hpvdt/falcon_motherboard/README.md

# Motherboard

Firmware and hardware designs for the Falcon motherboard.
