hpvdt/falcon_motherboard/hardware/motherboard_rev_3/motherboard_rev_3.kicad_pcb

## KiCad design hardware/motherboard_rev_3/motherboard_rev_3.kicad_pcb (2025-08-23)

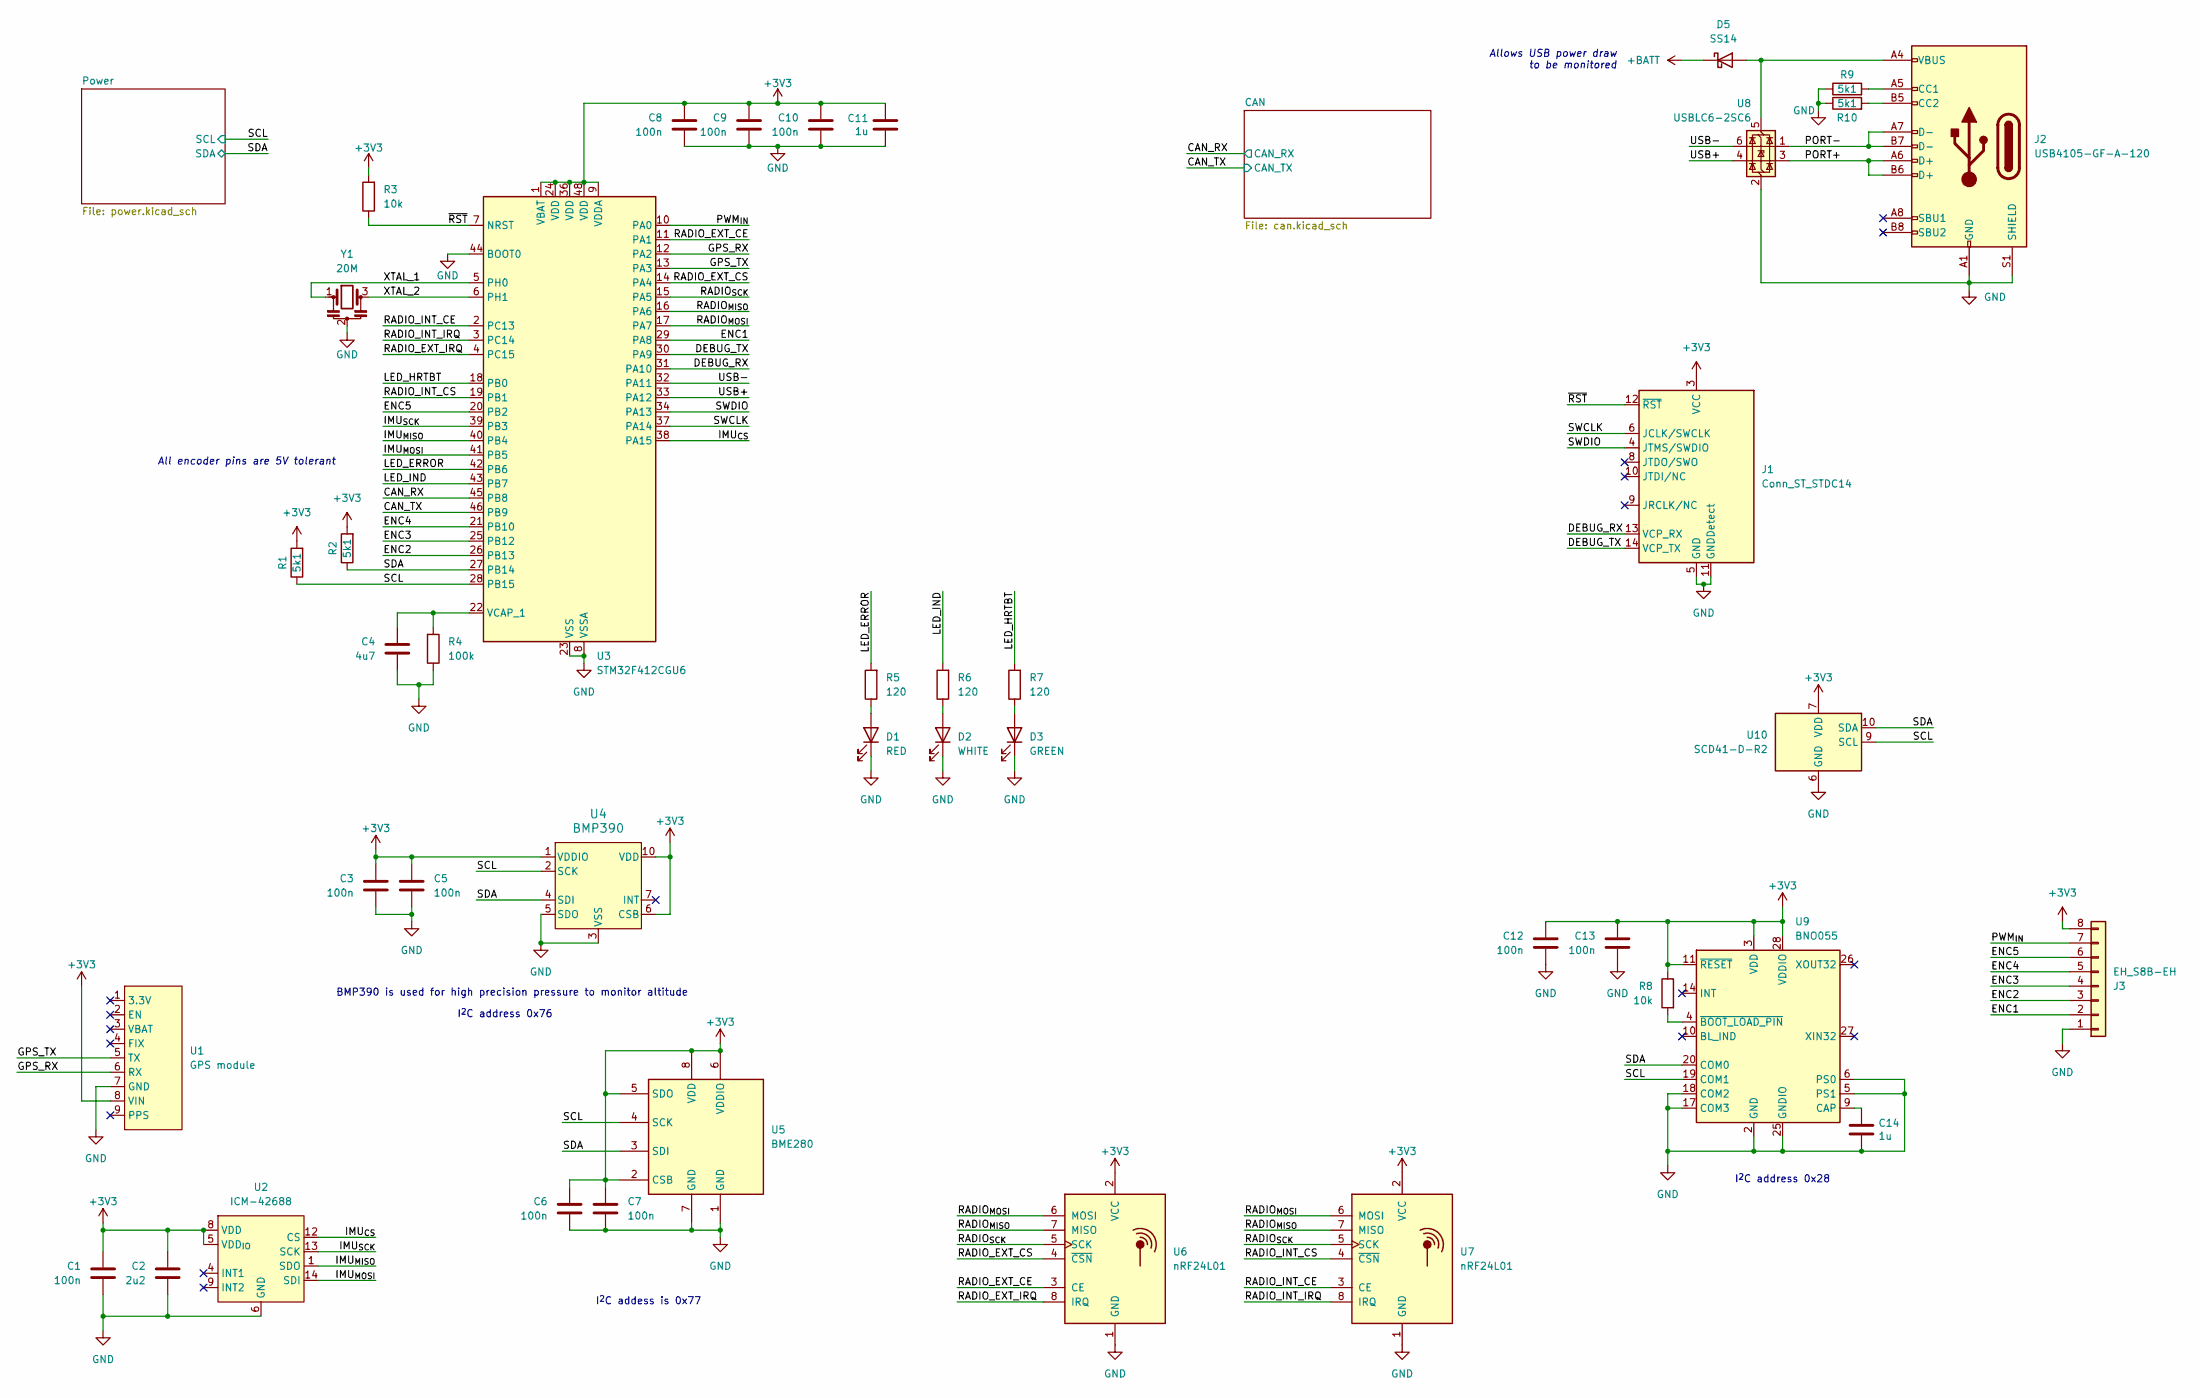
[picture p1: schematic motherboard_rev_3.kicad_sch, Falcon Motherboard]

Parts:
C1, C3, C5, C6, C7, C8, C9, C10, C12, C13: 100n; C_0402_1005Metric; LCSC C301928
C2: 2u2; C_0402_1005Metric; LCSC C12530
C4: 4u7; C_0603_1608Metric; LCSC C1705
C11, C14: 1u; C_0402_1005Metric; LCSC C52923
D1: RED; LED_0805_2012Metric; LCSC C84256
D2: WHITE; LED_0805_2012Metric; LCSC C34499
D3: GREEN; LED_0805_2012Metric; LCSC C2293
D5: SS14; D_SOD-123F; LCSC C2909920
J1: Conn_ST_STDC14; PinHeader_2x07_P1.27mm_Vertical_SMD; LCSC C2881912
J2: USB4105-GF-A-120; USB_C_Receptacle_GCT_USB4105-xx-A_16P_TopMnt_Horizontal; LCSC C5184243
J3: EH_S8B-EH; JST_EH_S8B-EH_1x08_P2.50mm_Horizontal; LCSC C265106
R1, R2, R9, R10: 5k1; R_0402_1005Metric; LCSC C25905
R3, R8: 10k; R_0402_1005Metric; LCSC C723353
R4: 100k; R_0402_1005Metric; LCSC C25530
R5, R6, R7: 120; R_0402_1005Metric; LCSC C25079
U1: GPS module; PinSocket_1x09_P2.54mm_Vertical
U2: ICM-42688; LGA-14_3x2.5mm_P0.5mm_LayoutBorder3x4y; LCSC C1850418
U3: STM32F412CGU6; QFN-48-1EP_7x7mm_P0.5mm_EP5.6x5.6mm; LCSC C2055817
U4: BMP390; LGA10_BMP390_BOS; LCSC C5124834
U5: BME280; Bosch_LGA-8_2.5x2.5mm_P0.65mm_ClockwisePinNumbering; LCSC C92489
U6, U7: nRF24L01; nRF24L01_Breakout
U8: USBLC6-2SC6; SOT-23-6; LCSC C7519
U9: BNO055; LGA-28_5.2x3.8mm_P0.5mm; LCSC C93216
U10: SCD41-D-R2; Sensirion_SCD4x-1EP_10.1x10.1mm_P1.25mm_EP4.8x4.8mm
Y1: 20M; Resonator_SMD_Murata_CSTxExxV-3Pin_3.0x1.1mm; LCSC C2650766

Connections:
+3V3: C1.1, C2.1, C3.1, C5.1, C6.1, C7.1, C8.1, C9.1, C10.1, C11.2, C12.1, C13.1, J1.3 (VCC), J3.8, R1.2, R2.2, R3.2, R8.1, U1.8 (VIN), U2.5 (VDD_{IO}), U2.8 (VDD), U3.1 (VBAT), U3.9 (VDDA), U3.24 (VDD), U3.36 (VDD), U3.48 (VDD), U4.1 (VDDIO), U4.6 (CSB), U4.10 (VDD), U5.2 (CSB), U5.5 (SDO), U5.6 (VDDIO), U5.8 (VDD), U6.2 (VCC), U7.2 (VCC), U9.3 (VDD), U9.11 (~RESET), U9.28 (VDDIO), U10.7 (VDD), U10.19 (VDD); also elsewhere on the board
+BATT: D5.1 (K); also elsewhere on the board
/CAN_RX: U3.45 (PB8); also elsewhere on the board
/CAN_TX: U3.46 (PB9); also elsewhere on the board
/DEBUG_RX: J1.13 (VCP_RX), U3.31 (PA10)
/DEBUG_TX: J1.14 (VCP_TX), U3.30 (PA9)
/ENC1: J3.2, U3.29 (PA8)
/ENC2: J3.3, U3.26 (PB13)
/ENC3: J3.4, U3.25 (PB12)
/ENC4: J3.5, U3.21 (PB10)
/ENC5: J3.6, U3.20 (PB2)
/GPS_RX: U1.6 (RX), U3.12 (PA2)
/GPS_TX: U1.5 (TX), U3.13 (PA3)
/IMU_{CS}: U2.12 (CS), U3.38 (PA15)
/IMU_{MISO}: U2.1 (SDO), U3.40 (PB4)
/IMU_{MOSI}: U2.14 (SDI), U3.41 (PB5)
/IMU_{SCK}: U2.13 (SCK), U3.39 (PB3)
/LED_ERROR: R5.2, U3.42 (PB6)
/LED_HRTBT: R7.2, U3.18 (PB0)
/LED_IND: R6.2, U3.43 (PB7)
/PORT+: J2.A6 (D+), J2.B6 (D+), U8.3 (I/O2)
/PORT-: J2.A7 (D-), J2.B7 (D-), U8.1 (I/O1)
/PWM_{IN}: J3.7, U3.10 (PA0)
/RADIO_EXT_CE: U3.11 (PA1), U6.3 (CE)
/RADIO_EXT_CS: U3.14 (PA4), U6.4 (~CSN)
/RADIO_EXT_IRQ: U3.4 (PC15), U6.8 (IRQ)
/RADIO_INT_CE: U3.2 (PC13), U7.3 (CE)
/RADIO_INT_CS: U3.19 (PB1), U7.4 (~CSN)
/RADIO_INT_IRQ: U3.3 (PC14), U7.8 (IRQ)
/RADIO_{MISO}: U3.16 (PA6), U6.7 (MISO), U7.7 (MISO)
/RADIO_{MOSI}: U3.17 (PA7), U6.6 (MOSI), U7.6 (MOSI)
/RADIO_{SCK}: U3.15 (PA5), U6.5 (SCK), U7.5 (SCK)
/SCL: R1.1, U3.28 (PB15), U4.2 (SCK), U5.4 (SCK), U9.19 (COM1), U10.9 (SCL); also elsewhere on the board
/SDA: R2.1, U3.27 (PB14), U4.4 (SDI), U5.3 (SDI), U9.20 (COM0), U10.10 (SDA); also elsewhere on the board
/SWCLK: J1.6 (JCLK/SWCLK), U3.37 (PA14)
/SWDIO: J1.4 (JTMS/SWDIO), U3.34 (PA13)
/USB+: U3.33 (PA12), U8.4 (I/O2)
/USB-: U3.32 (PA11), U8.6 (I/O1)
/XTAL_1: U3.5 (PH0), Y1.1
/XTAL_2: U3.6 (PH1), Y1.3
/~RST: J1.12 (~RST), R3.1, U3.7 (NRST)
GND: C1.2, C2.2, C3.2, C4.2, C5.2, C6.2, C7.2, C8.2, C9.2, C10.2, C11.1, C12.2, C13.2, C14.1, D1.1 (K), D2.1 (K), D3.1 (K), J1.5 (GND), J1.7 (GND), J1.11 (GNDDetect), J2.A1 (GND), J2.A12 (GND), J2.B1 (GND), J2.B12 (GND), J2.S1 (SHIELD), J3.1, R4.1, R9.1, R10.1, U1.7 (GND), U2.2 (RESV), U2.3 (RESV), U2.6 (GND), U2.7 (GND), U2.10 (RESV), U2.11 (RESV), U3.8 (VSSA), U3.23 (VSS), U3.35 (VSS), U3.44 (BOOT0), U3.47 (VSS), U3.49 (VSS), U4.3 (VSS), U4.5 (SDO), U4.8 (VSS), U4.9 (VSS), U5.1 (GND), U5.7 (GND), U6.1 (GND), U7.1 (GND), U8.2 (GND), U9.2 (GND), U9.5 (PS1), U9.6 (PS0), U9.17 (COM3), U9.18 (COM2), U9.25 (GNDIO), U10.6 (GND), U10.20 (GND), U10.21 (GND), Y1.2; also elsewhere on the board
unnamed: D1.2 (A), R5.1
unnamed: D2.2 (A), R6.1
unnamed: D3.2 (A), R7.1
unnamed: D5.2 (A), J2.A4 (VBUS), J2.A9 (VBUS), J2.B4 (VBUS), J2.B9 (VBUS), U8.5 (VBUS)
unnamed: J2.A5 (CC1), R9.2
unnamed: J2.B5 (CC2), R10.2
unnamed: C4.1, R4.2, U3.22 (VCAP_1)
unnamed: C14.2, U9.9 (CAP)
unnamed: R8.2, U9.4 (~BOOT_LOAD_PIN)

Notes on the sheet:
All encoder pins are 5V tolerant
BMP390 is used for high precision pressure to monitor altitude
Allows USB power draw to be monitored
I^{2}C addess is 0x77
I^{2}C address 0x28
I^{2}C address 0x76

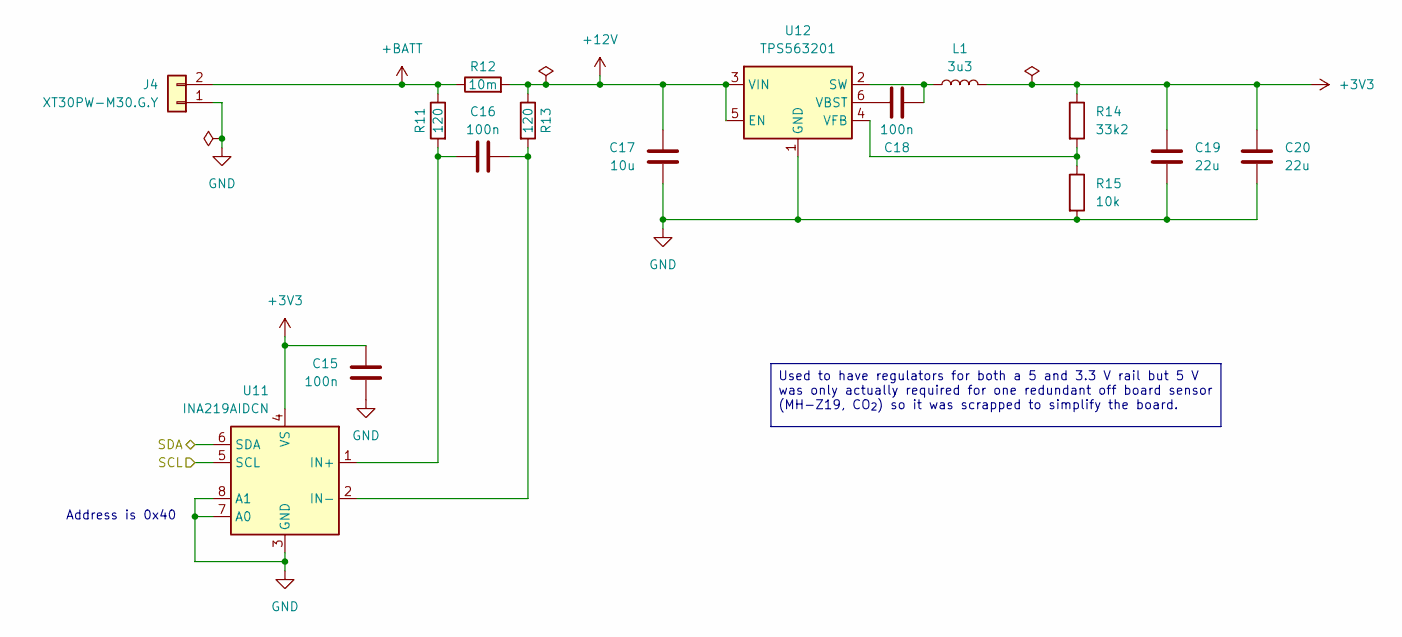
[picture p2: schematic power.kicad_sch, Power Regulation]

Parts:
C15, C16, C18: 100n; C_0402_1005Metric; LCSC C301928
C17: 10u; C_0603_1608Metric; LCSC C5360828
C19, C20: 22u; C_0603_1608Metric; LCSC C86295
J4: XT30PW-M30.G.Y; AMASS_XT30PW-M_1x02_P2.50mm_Horizontal; LCSC C431092
L1: 3u3; L_Changjiang_FNR6045S; LCSC C168063
R11, R13: 120; R_0402_1005Metric; LCSC C25079
R12: 10m; R_0805_2012Metric; LCSC C601083
R14: 33k2; R_0402_1005Metric; LCSC C122548
R15: 10k; R_0402_1005Metric; LCSC C723353
U11: INA219AIDCN; SOT-23-8; LCSC C87469
U12: TPS563201; SOT-23-6; LCSC C116592

Connections:
+3V3: C15.1, C19.1, C20.1, L1.2, R14.1, U11.4 (VS); also elsewhere on the board
+12V: C17.1, R12.2, R13.1, U12.3 (VIN), U12.5 (EN); also elsewhere on the board
+BATT: J4.2, R11.1, R12.1; also elsewhere on the board
/SCL: U11.5 (SCL); also elsewhere on the board
/SDA: U11.6 (SDA); also elsewhere on the board
GND: C15.2, C17.2, C19.2, C20.2, J4.1, R15.2, U11.3 (GND), U11.7 (A0), U11.8 (A1), U12.1 (GND); also elsewhere on the board
unnamed: C16.2, R11.2, U11.1 (IN+)
unnamed: C16.1, R13.2, U11.2 (IN-)
unnamed: C18.2, L1.1, U12.2 (SW)
unnamed: C18.1, U12.6 (VBST)
unnamed: R14.2, R15.1, U12.4 (VFB)

Notes on the sheet:
Address is 0x40
Used to have regulators for both a 5 and 3.3 V rail but 5 V was only actually required for one redundant off board sensor (MH-Z19, CO_{2}) so it was scrapped to simplify the board.

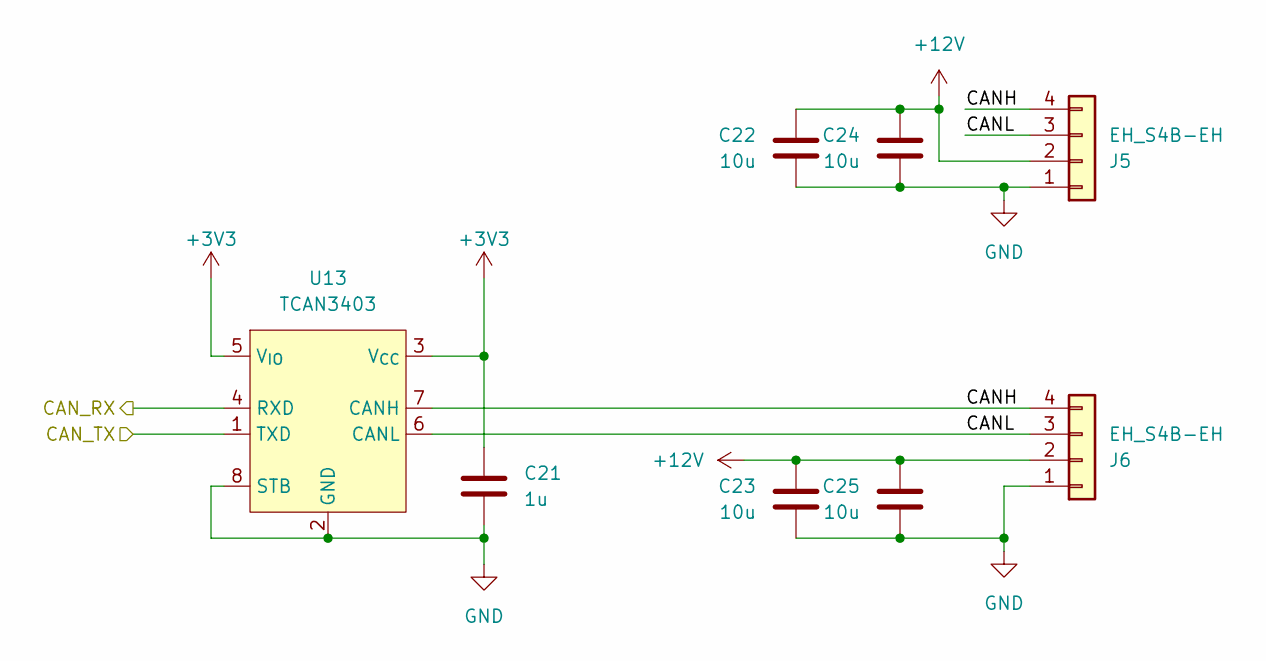
[picture p3: schematic can.kicad_sch, CAN Interface]

Parts:
C21: 1u; C_0402_1005Metric; LCSC C52923
C22, C23, C24, C25: 10u; C_0603_1608Metric; LCSC C5360828
J5, J6: EH_S4B-EH; JST_EH_S4B-EH_1x04_P2.50mm_Horizontal; LCSC C265068
U13: TCAN3403; TSOT-23-8; LCSC C35926232

Connections:
+3V3: C21.1, U13.3 (V_{CC}), U13.5 (V_{IO}); also elsewhere on the board
+12V: C22.1, C23.1, C24.1, C25.1, J5.2, J6.2; also elsewhere on the board
/CAN/CANH: J5.4, J6.4, U13.7 (CANH)
/CAN/CANL: J5.3, J6.3, U13.6 (CANL)
/CAN_RX: U13.4 (RXD); also elsewhere on the board
/CAN_TX: U13.1 (TXD); also elsewhere on the board
GND: C21.2, C22.2, C23.2, C24.2, C25.2, J5.1, J6.1, U13.2 (GND), U13.8 (STB); also elsewhere on the board

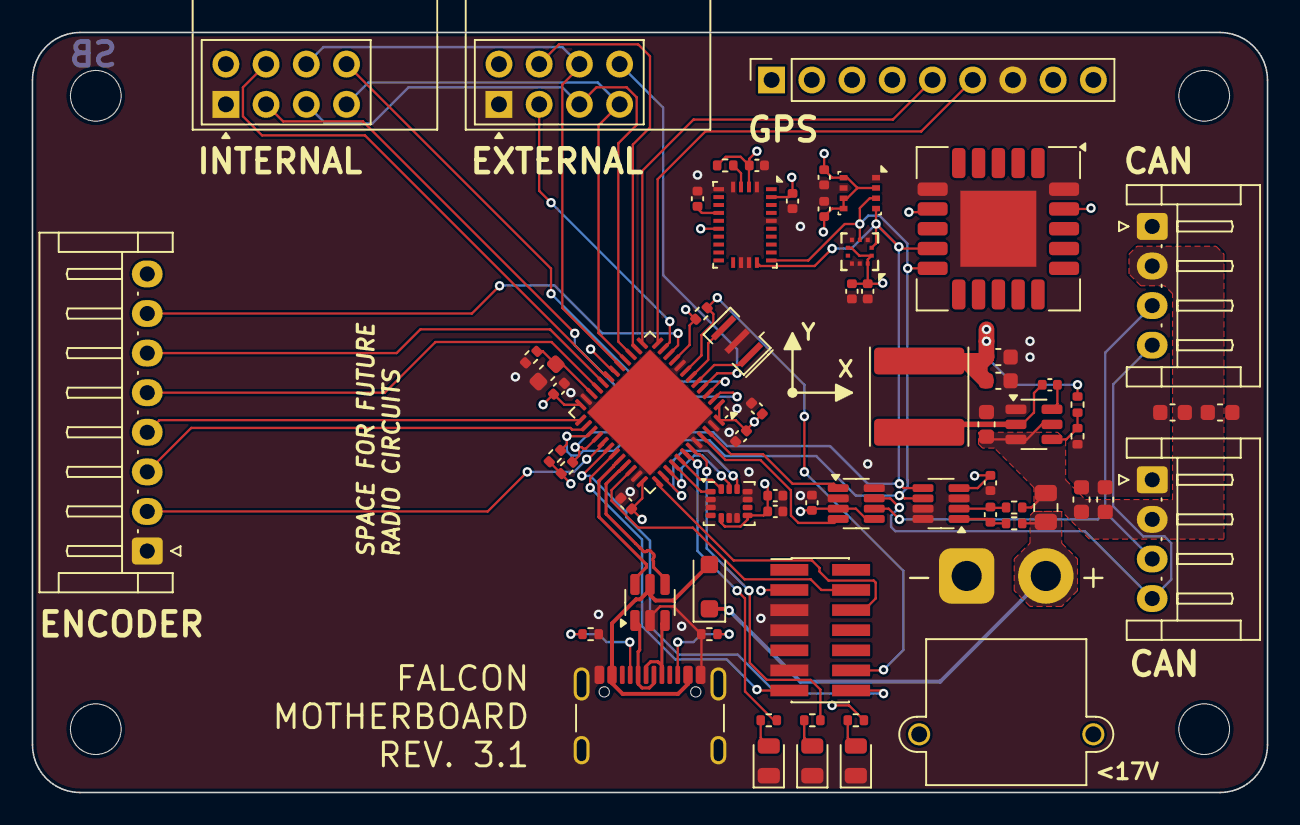
[picture p4: board motherboard_rev_3.kicad_pcb from above]

Board: 4 copper layers, 78.0 x 48.0 mm, 65 parts (0 on the bottom side), 59 nets.
