hpvdt/falcon_motherboard/hardware/motherboard_rev_1/motherboard_rev_1.kicad_pcb

## KiCad design hardware/motherboard_rev_1/motherboard_rev_1.kicad_pcb (2025-08-17, an earlier design)

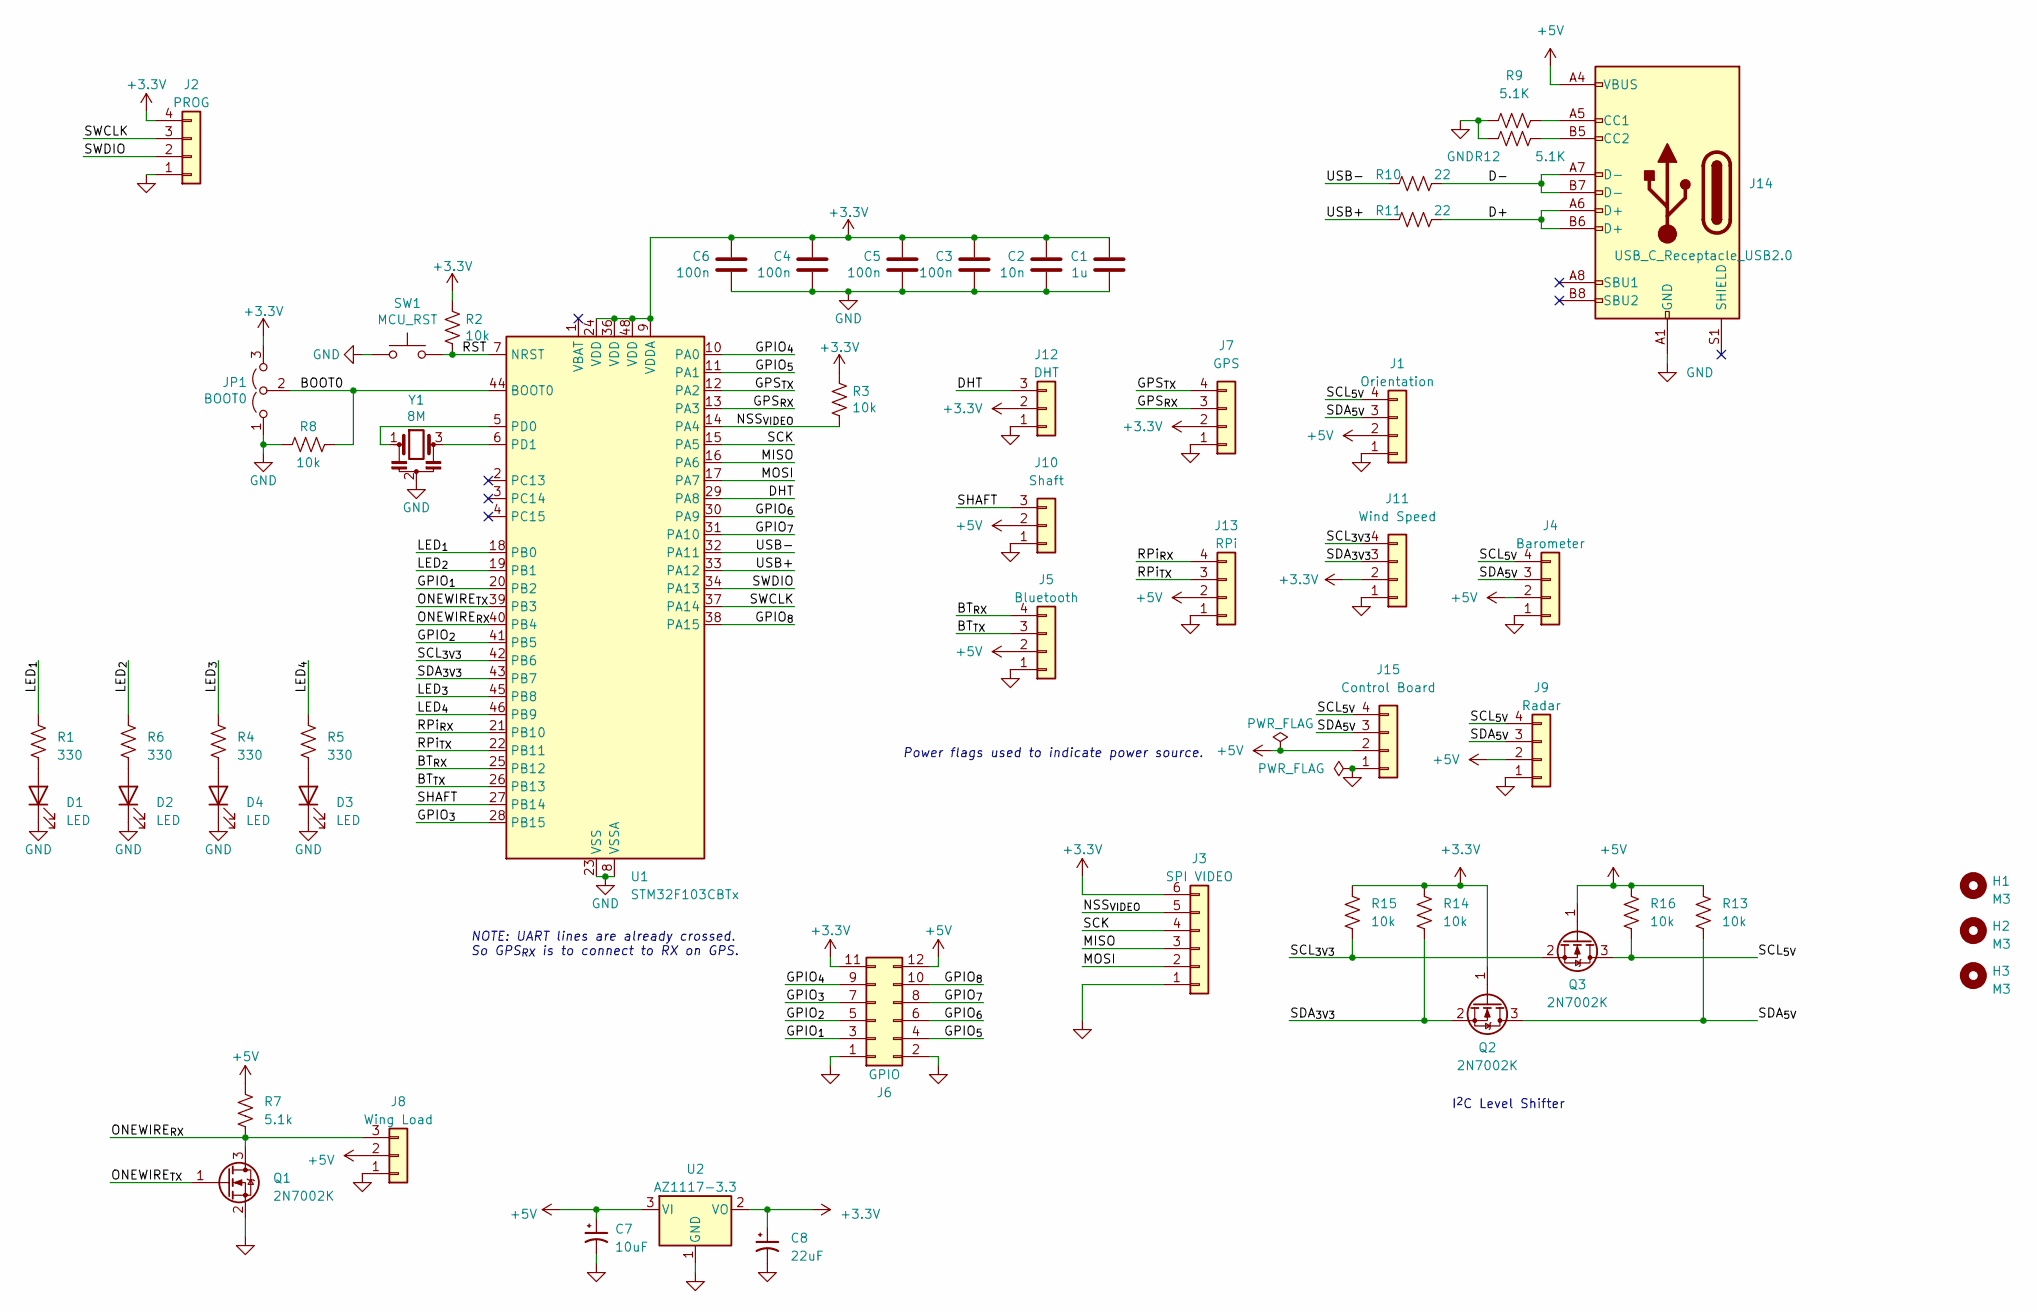
[picture p5: schematic motherboard_rev_1.kicad_sch, Aircraft Sensor Board]

Parts:
C1: 1u; C_0603_1608Metric
C2: 10n; C_0603_1608Metric
C3, C4, C5, C6: 100n; C_0603_1608Metric
C7: 10uF; CP_Radial_D5.0mm_P2.00mm
C8: 22uF; CP_Radial_D5.0mm_P2.00mm
D1, D2, D3, D4: LED; LED_0805_2012Metric
H1, H2, H3: M3; MountingHole_3.2mm_M3
J1: Orientation; JST_EH_B4B-EH-A_1x04_P2.50mm_Vertical
J2: PROG; JST_EH_B4B-EH-A_1x04_P2.50mm_Vertical
J3: SPI VIDEO; JST_EH_B6B-EH-A_1x06_P2.50mm_Vertical
J4: Barometer; JST_EH_B4B-EH-A_1x04_P2.50mm_Vertical
J5: Bluetooth; JST_EH_B4B-EH-A_1x04_P2.50mm_Vertical
J6: GPIO; PinHeader_2x06_P2.54mm_Vertical
J7: GPS; JST_EH_B4B-EH-A_1x04_P2.50mm_Vertical
J8: Wing Load; JST_EH_B3B-EH-A_1x03_P2.50mm_Vertical
J9: Radar; JST_EH_B4B-EH-A_1x04_P2.50mm_Vertical
J10: Shaft; JST_EH_B3B-EH-A_1x03_P2.50mm_Vertical
J11: Wind Speed; JST_EH_B4B-EH-A_1x04_P2.50mm_Vertical
J12: DHT; JST_EH_B3B-EH-A_1x03_P2.50mm_Vertical
J13: RPi; JST_EH_B4B-EH-A_1x04_P2.50mm_Vertical
J14: USB_C_Receptacle_USB2.0; USB_C_Receptacle_HRO_TYPE-C-31-M-12
J15: Control Board; JST_EH_B4B-EH-A_1x04_P2.50mm_Vertical
JP1: BOOT0; PinHeader_1x03_P2.54mm_Vertical
Q1, Q2, Q3: 2N7002K; SOT-23
R1, R4, R5, R6: 330; R_0603_1608Metric
R2, R3, R8, R13, R14, R15, R16: 10k; R_0603_1608Metric
R7: 5.1k; R_0603_1608Metric
R9, R12: 5.1K; R_0603_1608Metric
R10, R11: 22; R_0603_1608Metric
SW1: MCU_RST; SW_PUSH_6mm_H4.3mm
U1: STM32F103CBTx; LQFP-48_7x7mm_P0.5mm
U2: AZ1117-3.3; SOT-223-3_TabPin2
Y1: 8M; Resonator_SMD_Murata_CSTxExxV-3Pin_3.0x1.1mm

Connections:
+3.3V: C1.2, C2.2, C3.2, C4.2, C5.2, C6.2, C8.1, J2.4, J3.6, J6.11, J7.2, J11.2, J12.2, JP1.3 (B), Q2.1 (G), R2.2, R3.2, R14.1, R15.1, U1.9 (VDDA), U1.24 (VDD), U1.36 (VDD), U1.48 (VDD), U2.2 (VO)
+5V: C7.1, J1.2, J4.2, J5.2, J6.12, J8.2, J9.2, J10.2, J13.2, J14.A4 (VBUS), J14.A9 (VBUS), J14.B4 (VBUS), J14.B9 (VBUS), J15.2, Q3.1 (G), R7.1, R13.1, R16.1, U2.3 (VI)
/BOOT0: JP1.2 (C), R8.2, U1.44 (BOOT0)
/BT_{RX}: J5.4, U1.25 (PB12)
/BT_{TX}: J5.3, U1.26 (PB13)
/D+: J14.A6 (D+), J14.B6 (D+), R11.2
/D-: J14.A7 (D-), J14.B7 (D-), R10.2
/DHT: J12.3, U1.29 (PA8)
/GPIO_{1}: J6.3, U1.20 (PB2)
/GPIO_{2}: J6.5, U1.41 (PB5)
/GPIO_{3}: J6.7, U1.28 (PB15)
/GPIO_{4}: J6.9, U1.10 (PA0)
/GPIO_{5}: J6.4, U1.11 (PA1)
/GPIO_{6}: J6.6, U1.30 (PA9)
/GPIO_{7}: J6.8, U1.31 (PA10)
/GPIO_{8}: J6.10, U1.38 (PA15)
/GPS_{RX}: J7.3, U1.13 (PA3)
/GPS_{TX}: J7.4, U1.12 (PA2)
/LED_{1}: R1.1, U1.18 (PB0)
/LED_{2}: R6.1, U1.19 (PB1)
/LED_{3}: R4.1, U1.45 (PB8)
/LED_{4}: R5.1, U1.46 (PB9)
/MISO: J3.3, U1.16 (PA6)
/MOSI: J3.2, U1.17 (PA7)
/NSS_{VIDEO}: J3.5, R3.1, U1.14 (PA4)
/ONEWIRE_{RX}: J8.3, Q1.3 (D), R7.2, U1.40 (PB4)
/ONEWIRE_{TX}: Q1.1 (G), U1.39 (PB3)
/RPi_{RX}: J13.4, U1.21 (PB10)
/RPi_{TX}: J13.3, U1.22 (PB11)
/RST: R2.1, SW1.2, U1.7 (NRST)
/SCK: J3.4, U1.15 (PA5)
/SCL_{3V3}: J11.4, Q3.2 (S), R15.2, U1.42 (PB6)
/SCL_{5V}: J1.4, J4.4, J9.4, J15.4, Q3.3 (D), R16.2
/SDA_{3V3}: J11.3, Q2.2 (S), R14.2, U1.43 (PB7)
/SDA_{5V}: J1.3, J4.3, J9.3, J15.3, Q2.3 (D), R13.2
/SHAFT: J10.3, U1.27 (PB14)
/SWCLK: J2.3, U1.37 (PA14)
/SWDIO: J2.2, U1.34 (PA13)
/USB+: R11.1, U1.33 (PA12)
/USB-: R10.1, U1.32 (PA11)
unnamed: D1.2 (A), R1.2
unnamed: D2.2 (A), R6.2
unnamed: D3.2 (A), R5.2
unnamed: D4.2 (A), R4.2
unnamed: J14.A5 (CC1), R9.2
unnamed: J14.B5 (CC2), R12.2
unnamed: U1.5 (PD0), Y1.1
unnamed: U1.6 (PD1), Y1.3

Notes on the sheet:
NOTE: UART lines are already crossed. So GPS_{RX} is to connect to RX on GPS.
Power flags used to indicate power source.
I^{2}C Level Shifter

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
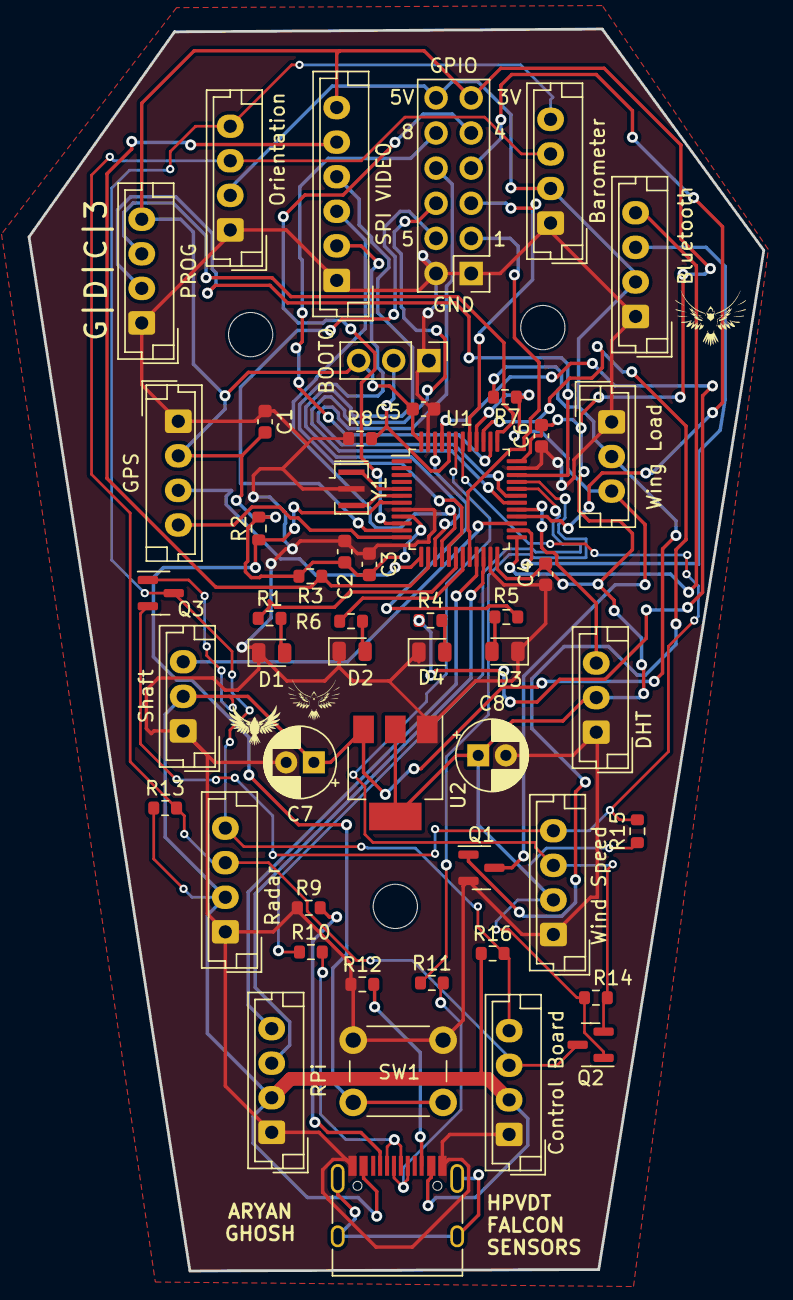
[picture p6: board motherboard_rev_1.kicad_pcb from above]

Board: 2 copper layers, 53.1 x 89.8 mm, 54 parts (0 on the bottom side), 49 nets.
