hpvdt/falcon_motherboard/hardware/motherboard_rev_2/motherboard_rev_2.kicad_pcb

## KiCad design hardware/motherboard_rev_2/motherboard_rev_2.kicad_pcb (2025-08-17, an earlier design)

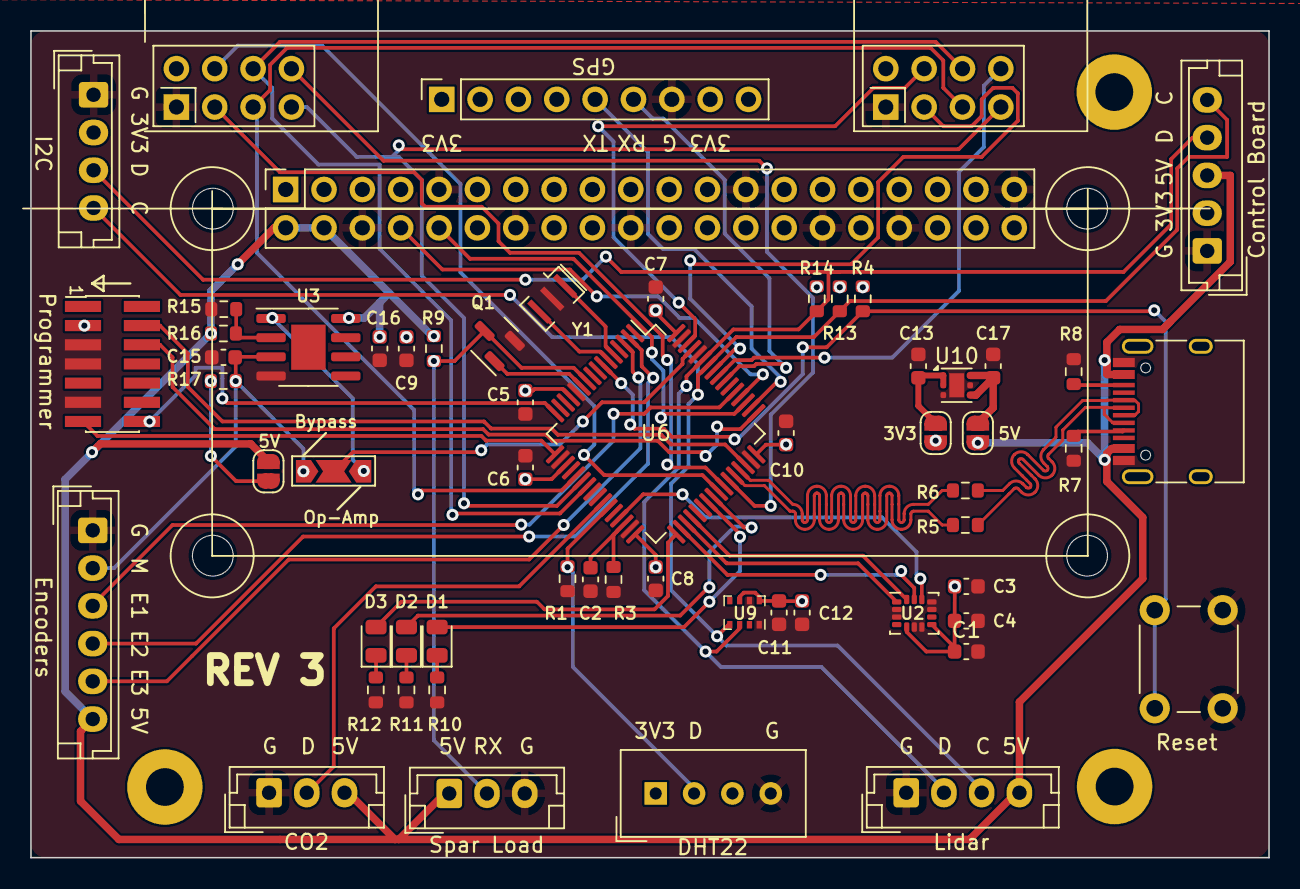
[picture p7: board motherboard_rev_2.kicad_pcb from above]

Board: 2 copper layers, 82.0 x 54.8 mm, 67 parts (0 on the bottom side), 56 nets.

Parts:
C1, C9, C15: 10n; C_0603_1608Metric
C2: 4.7u; C_0603_1608Metric
C3: 2.2u; C_0603_1608Metric
C4, C5, C6, C7, C8, C11, C12, C16: 100n; C_0603_1608Metric
C10: 1u; C_0603_1608Metric
C13, C17: 0.22u; C_0603_1608Metric
D1, D2, D3: LED; LED_0805_2012Metric
H1, H3, H4: MountingHole; MountingHole_2.5mm_Pad
H5, H6, H7, H8: MountingHole; MountingHole_2.7mm_M2.5
J1: Raspberry_Pi_2_3 ANT; PinSocket_2x20_P2.54mm_Vertical
J2: Conn_ST_STDC14; PinHeader_2x07_P1.27mm_Vertical_SMD
J3: Battery / Pitot/ Orientation; JST_EH_B4B-EH-A_1x04_P2.50mm_Vertical
J4: c02 censor; JST_EH_B3B-EH-A_1x03_P2.50mm_Vertical
J5: shaftencorder; JST_EH_B6B-EH-A_1x06_P2.50mm_Vertical
J6: USB_C_Receptacle_USB2.0; USB_C_Receptacle_HRO_TYPE-C-31-M-12
J7: SparLoad; JST_EH_B3B-EH-A_1x03_P2.50mm_Vertical
J8: lidar; JST_EH_B4B-EH-A_1x04_P2.50mm_Vertical
J9: Control Board; JST_EH_B5B-EH-A_1x05_P2.50mm_Vertical
JP1: Jumper_3_Open; SolderJumper-3_P2.0mm_Open_TrianglePad1.0x1.5mm_NumberLabels
JP4: 5V; SolderJumper-2_P1.3mm_Open_RoundedPad1.0x1.5mm
JP5, JP6: Jumper_2_Open; SolderJumper-2_P1.3mm_Open_RoundedPad1.0x1.5mm
Q1: 2N7002K; SOT-23
R1, R3: 100k; R_0603_1608Metric
R4, R13, R14: 10k; R_0603_1608Metric
R5, R6: 22R; R_0603_1608Metric
R7, R8: 5.1K; R_0603_1608Metric
R9: 5.6k; R_0603_1608Metric
R10, R11, R12: 130R; R_0603_1608Metric
R15: 1k; R_0603_1608Metric
R16: 20k; R_0603_1608Metric
R17: 470R; R_0603_1608Metric
SW1: MCU_RST; SW_PUSH_6mm_H4.3mm
U2: IMU; LGA-14_3x2.5mm_P0.5mm_LayoutBorder3x4y
U3: LM358; SOIC-8-1EP_3.9x4.9mm_P1.27mm_EP2.29x3mm
U4: GPS module; PinSocket_1x09_P2.54mm_Vertical
U5: DHT11(DHT22); Aosong_DHT11_5.5x12.0_P2.54mm
U6: STM32F412RETx; LQFP-64_10x10mm_P0.5mm
U7: nRF24L01-telemetry-INTERIOR; nRF24L01_Breakout
U8: nRF24L01-telemetry-EXTERIOR; nRF24L01_Breakout
U9: DPS310 - barometer; Bosch_LGA-8_2x2.5mm_P0.65mm_ClockwisePinNumbering
U10: TLV76733DRVx; WSON-6-1EP_2x2mm_P0.65mm_EP1x1.6mm
Y1: 8M; Resonator_SMD_Murata_CSTxExxV-3Pin_3.0x1.1mm

Connections:
+3.3V: C1.1, C3.1, C4.1, C5.2, C6.2, C7.2, C8.2, C9.2, C10.2, C11.1, C12.1, J2.3 (VCC), J3.2, J9.2, JP5.2 (B), R4.2, R13.1, R14.1, U2.5 (VDD_{IO}), U2.8 (VDD), U4.1 (3.3V), U4.8 (VIN), U5.1 (VDD), U6.13 (VDDA), U6.19 (VDD), U6.32 (VDD), U6.48 (VDD), U6.64 (VDD), U7.2 (VCC), U8.2 (VCC), U9.6 (V_{DDIO}), U9.8 (V_{DD})
+5V: C16.1, J1.2 (5V), J1.4 (5V), J4.3, J5.6, J6.A4 (VBUS), J6.A9 (VBUS), J6.B4 (VBUS), J6.B9 (VBUS), J7.1, J8.4, J9.3, JP4.2 (B), JP6.1 (A), R9.1, R16.1, U3.8 (V+)
/CO_{2}: J4.2, U6.26 (PB0)
/D+: J6.A6 (D+), J6.B6 (D+), R6.2
/D-: J6.A7 (D-), J6.B7 (D-), R5.2
/DHT22: R1.2, U5.2 (DATA), U6.27 (PB1)
/ENC1: J5.3, U6.53 (PC12)
/ENC2: J5.4, U6.2 (PC13)
/ENC3: J5.5, U6.3 (PC14)
/I2C_{SCK}: J3.4, J8.3, J9.5, R13.2, U6.58 (PB6), U9.4 (SCK)
/I2C_{SDA}: J3.3, J8.2, J9.4, R14.2, U6.59 (PB7), U9.3 (SDI)
/IMU_{CS}: U2.12 (CS), U6.29 (PB10)
/LED1: D1.2 (A), U6.39 (PC8)
/LED2: D2.2 (A), U6.40 (PC9)
/LED3: D3.2 (A), U6.33 (PB12)
/OneWire_{RX}: J7.2, Q1.3 (D), R9.2, U6.10 (PC2)
/OneWire_{TX}: Q1.1 (G), U6.11 (PC3)
/RST: R4.1, SW1.2, U6.7 (NRST)
/SHAFTENC IN: C15.1, J5.2, JP1.1 (A), R17.2, U3.3 (+)
/SHAFTENC OUT: JP1.2 (C), U6.61 (PB8)
/SPI1MISO: U6.22 (PA6), U7.7 (MISO), U8.7 (MISO)
/SPI1MOSI: U6.23 (PA7), U7.6 (MOSI), U8.6 (MOSI)
/SPI1SCK: U6.21 (PA5), U7.5 (SCK), U8.5 (SCK)
/SPI2MISO: U2.1 (SDO), U6.35 (PB14)
/SPI2MOSI: U2.14 (SDI), U6.36 (PB15)
/SPI2SCK: U2.13 (SCK), U6.34 (PB13)
/SWCLK: J2.6 (JCLK/SWCLK), U6.49 (PA14)
/SWDIO: J2.4 (JTMS/SWDIO), U6.46 (PA13)
/TELE_{CE}-E: U6.42 (PA9), U8.3 (CE)
/TELE_{CE}-int: U6.57 (PB5), U7.3 (CE)
/TELE_{CS}-E: U6.41 (PA8), U8.4 (~CSN)
/TELE_{CS}-int: U6.62 (PB9), U7.4 (~CSN)
/TELE_{IRQ}-E: U6.43 (PA10), U8.8 (IRQ)
/TELE_{IRQ}-int: U6.56 (PB4), U7.8 (IRQ)
/USART1_{RX}: U4.6 (RX), U6.55 (PB3)
/USART1_{TX}: U4.5 (TX), U6.50 (PA15)
/USART2_{RX}: J2.13 (VCP_RX), U6.17 (PA3)
/USART2_{TX}: J2.14 (VCP_TX), U6.16 (PA2)
/USART3_{RX}: J1.8 (GPIO14/TXD), U6.52 (PC11)
/USART3_{TX}: J1.10 (GPIO15/RXD), U6.51 (PC10)
/USB+: R6.1, U6.45 (PA12)
/USB-: R5.1, U6.44 (PA11)
GND: C1.2, C2.2, C3.2, C4.2, C5.1, C6.1, C7.1, C8.1, C9.1, C10.1, C11.2, C12.2, C13.2, C15.2, C16.2, C17.2, J1.6 (GND), J1.9 (GND), J1.14 (GND), J1.20 (GND), J1.25 (GND), J1.30 (GND), J1.34 (GND), J1.39 (GND), J2.5 (GND), J2.7 (GND), J2.11 (GNDDetect), J3.1, J4.1, J5.1, J6.A1 (GND), J6.A12 (GND), J6.B1 (GND), J6.B12 (GND), J7.3, J8.1, J9.1, Q1.2 (S), R1.1, R3.1, R7.1, R8.1, R10.1, R11.1, R12.2, R15.2, SW1.1, U2.2 (RESV), U2.3 (RESV), U2.6 (GND), U2.7 (RESV), U2.10 (RESV), U2.11 (RESV), U3.4 (V-), U4.7 (GND), U5.4 (GND), U6.12 (VSSA), U6.18 (VSS), U6.31 (VSS), U6.47 (VSS), U6.60 (BOOT0), U6.63 (VSS), U7.1 (GND), U8.1 (GND), U9.1 (GND), U9.7 (GND), U10.3 (GND), U10.5 (GND), U10.7 (PAD), Y1.2
unnamed: D1.1 (K), R10.2
unnamed: D2.1 (K), R11.2
unnamed: D3.1 (K), R12.1
unnamed: J6.A5 (CC1), R7.2
unnamed: J6.B5 (CC2), R8.2
unnamed: JP1.3 (B), U3.1
unnamed: JP4.1 (A), R17.1
unnamed: C13.1, JP5.1 (A), U10.1 (OUT), U10.2 (SNS)
unnamed: C17.1, JP6.2 (B), U10.4 (EN), U10.6 (IN)
unnamed: R15.1, R16.2, U3.2 (-)
unnamed: U6.5 (PH0), Y1.1
unnamed: U6.6 (PH1), Y1.3
unnamed: C2.1, R3.2, U6.30 (VCAP_1)
