hpvdt/falcon_motherboard/firmware/mother_board_stmcube/Core/Src/main.c

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
/* Includes ------------------------------------------------------------------*/
#include "main.h"
#include "can.h"
#include "fmpi2c.h"
#include "spi.h"
#include "tim.h"
#include "usart.h"
#include "usb_device.h"
#include "gpio.h"

/* USER CODE BEGIN Includes */
#include <stdbool.h>
#include <stdint.h>
#include "usbd_cdc_if.h"
#include "string.h"
#include "led_operation.h"
#include "can_wrapper.h"
#include "wing_modules.h"
#include "ina219.h"
#include "atmosphere.h"
#include "position.h"
#include "radio.h"
/* USER CODE END Includes */


/* USER CODE BEGIN PV */
TIM_HandleTypeDef* led_err_clk = &htim4;
uint32_t led_err_chn = TIM_CHANNEL_1;
TIM_HandleTypeDef* led_ind_clk = &htim4;
uint32_t led_ind_chn = TIM_CHANNEL_2;
TIM_HandleTypeDef* led_heartbeat_clk = &htim3;
uint32_t led_heartbeat_chn = TIM_CHANNEL_3;

const uint32_t I2C_TIMEOUT = 10; // Timeout to be used for I2C interactions


/* USER CODE END PV */

void SystemClock_Config(void);
/* USER CODE BEGIN PFP */
#ifdef __GNUC__
/* With GCC/RAISONANCE, small printf (option LD Linker->Libraries->Small printf
   set to 'Yes') calls __io_putchar() */
#define PUTCHAR_PROTOTYPE int __io_putchar(int ch)
#else
#define PUTCHAR_PROTOTYPE int fputc(int ch, FILE *f)
#endif /* __GNUC__ */
/* USER CODE END PFP */

/**
  * @brief  The application entry point.
  * @retval int
  */
int main(void)
{

  /* MCU Configuration--------------------------------------------------------*/

  /* Reset of all peripherals, Initializes the Flash interface and the Systick. */
  HAL_Init();

  /* Configure the system clock */
  SystemClock_Config();

  /* Initialize all configured peripherals */
  MX_GPIO_Init();
  MX_USB_DEVICE_Init();
  MX_CAN1_Init();
  MX_FMPI2C1_Init();
  MX_USART1_UART_Init();
  MX_USART2_UART_Init();
  MX_SPI1_Init();
  MX_SPI3_Init();
  MX_TIM3_Init();
  MX_TIM4_Init();
  MX_TIM2_Init();
  MX_TIM1_Init();
  MX_TIM8_Init();
  /* USER CODE BEGIN 2 */
  	struct CompleteAircraftData aircraft_data = {0};

	struct LEDMoBoConfig led_config = {
		  .error_timer = led_err_clk,
		  .error_channel = led_err_chn,
		  .indicator_timer = led_ind_clk,
		  .indicator_channel = led_ind_chn,
		  .heartbeat_timer = led_heartbeat_clk,
		  .heartbeat_channel = led_heartbeat_chn,
	};
	led_setup(&led_config);

//	wing_setup(&hcan1);
	uint8_t usb_tx_buffer[500] = {0};
	uint16_t usb_tx_length = 0;

	HAL_StatusTypeDef ret = ina219_setup(&hfmpi2c1, I2C_TIMEOUT);
	printf("INA219 setup result: %d\n\r", ret);

	ret = atmo_setup(&hfmpi2c1, I2C_TIMEOUT);

	ret = pos_setup(&hfmpi2c1, I2C_TIMEOUT);

	radio_setup();
  /* USER CODE END 2 */

  /* Infinite loop */
  /* USER CODE BEGIN WHILE */
  while (1)
  {
//	  if (HAL_CAN_GetRxFifoFillLevel(&hcan1, CAN_LOAD_FIFO) > 0) {
//		  CAN_RxHeaderTypeDef rx_header = {0};
//		  uint8_t rx_buffer[8] = {0};
//		  HAL_CAN_GetRxMessage(&hcan1, CAN_LOAD_FIFO, &rx_header, rx_buffer);
//
//		  wing_record_strain(rx_header.StdId, rx_buffer);
//	  }
    /* USER CODE END WHILE */

    /* USER CODE BEGIN 3 */

		uint32_t data_sent = HAL_GetTick();

		radio_broadcast_data(&aircraft_data);

		radio_receive_internal(&aircraft_data);

      led_operate(&led_config);

//		uint32_t current_tick = HAL_GetTick();
//		const uint32_t PRINT_PERIOD_TICKS = 1000;
//		static uint32_t next_print_tick = 0;
//		if (current_tick > next_print_tick) {
//			usb_tx_length = print_nice_loading(usb_tx_buffer, sizeof(usb_tx_buffer));
//			next_print_tick = current_tick + PRINT_PERIOD_TICKS;
//		}
//		else buffer[0] = '\0'; // Nullify the buffer

//      if (usb_tx_length > 0) {
//    	  CDC_Transmit_FS(usb_tx_buffer, usb_tx_length);
//    	  wing_setup(&hcan1);
//      }
      HAL_Delay(1000);

//      struct AtmoConditions atmo_cond = {0};
//      ret = atmo_conditions_update(&atmo_cond);
//      printf("[%d]T: %.2f\tH: %.2f\tP: %.2f\tCO2: %d\n\r", ret, atmo_cond.temperature_c,
//    		  atmo_cond.humidity_rel, atmo_cond.static_pressure_pa, atmo_cond.co2_ppm);
//      struct OrientationState orientation = {0};
//      ret = pos_orientation_update(&orientation);
//      printf("[%d]R: %6.1f\tP: %6.1f\tY: %6.1f\n\r", ret, orientation.roll_deg, orientation.pitch_deg, orientation.yaw_deg);
  }
  /* USER CODE END 3 */
}

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
/* USER CODE BEGIN 4 */
/**
  * @brief  Retargets the C library printf function to the USART.
  * @param  None
  * @retval None
  */
PUTCHAR_PROTOTYPE
{
  /* Place your implementation of fputc here */
  /* e.g. write a character to the USART1 and Loop until the end of transmission */
  HAL_UART_Transmit(&huart1, (uint8_t *)&ch, 1, 0xFFFF);

  return ch;
}
/* USER CODE END 4 */
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
