hpvdt/falcon_motherboard/firmware/mother_board_stmcube/Core/Inc/atmosphere.h

/*
 * atmosphere.h
 *
 *  Created on: Nov 12, 2025
 *      Author: savo
 */

#ifndef INC_ATMOSPHERE_H_
#define INC_ATMOSPHERE_H_

#include "stm32f4xx_hal.h"
#include "stm32f4xx_hal_fmpi2c.h"
#include "falcon_data.h"

HAL_StatusTypeDef atmo_setup(FMPI2C_HandleTypeDef* bus, uint32_t i2c_timeout_ms);

HAL_StatusTypeDef atmo_conditions_update(struct AtmoConditions* target);

#endif /* INC_ATMOSPHERE_H_ */
