hpvdt/falcon_motherboard/firmware/mother_board_platformio/include/communications.hpp

#include <Arduino.h>
#include "aircraft_data.h"

enum MessageType : uint8_t {
    MESSAGE_TYPE_MAIN           = 'm',
    MESSAGE_TYPE_STRAIN         = 's',
    MESSAGE_TYPE_GPS            = 'g',
    MESSAGE_TYPE_PRETTY_STRAIN  = 'S',
};

enum CommunicationChannel {
    COMM_CHANNEL_USB,
    COMM_CHANNEL_RADIO,
};

/**
 * \brief Set the up USB/PC communications
 * 
 * \param block Block until connection is confirmed or not
 */
void setup_pc_comms(bool block);

/**
 * \brief Broadcast a formatted message about the aircrtaft's state on a channel
 * 
 * \param msg_type Message type to send
 * \param chn Communications channel to boardcast it on
 * \param state Aircraft state data to use
 * 
 * \return Any error code for transmissions (`0` for OK)
 */
int send_mesage(MessageType msg_type, CommunicationChannel chn, AircraftState* state);

/**
 * \brief Broadcast a test formatted message about the aircrtaft's state on a channel
 * 
 * \param msg_type Message type to send
 * \param chn Communications channel to boardcast it on
 * 
 * \return Any error code for transmissions (`0` for OK)
 */
int send_test_mesage(MessageType msg_type, CommunicationChannel chn);
