hpvdt/falcon_motherboard/firmware/falcon_calibration/Core/Src/main.c

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
/* Includes ------------------------------------------------------------------*/
#include "main.h"
#include "usb_device.h"

/* USER CODE BEGIN Includes */
#include <stdbool.h>
#include <stdint.h>
#include "usbd_cdc_if.h"
#include "string.h"
#include "led_operation.h"
#include "can_wrapper.h"
#include "wing_modules.h"
#include "command_line.h"
/* USER CODE END Includes */

CAN_HandleTypeDef hcan1;

FMPI2C_HandleTypeDef hfmpi2c1;

SPI_HandleTypeDef hspi1;
SPI_HandleTypeDef hspi3;

TIM_HandleTypeDef htim1;
TIM_HandleTypeDef htim2;
TIM_HandleTypeDef htim3;
TIM_HandleTypeDef htim4;

UART_HandleTypeDef huart1;
UART_HandleTypeDef huart2;

/* USER CODE BEGIN PV */
TIM_HandleTypeDef* led_err_clk = &htim4;
uint32_t led_err_chn = TIM_CHANNEL_1;
TIM_HandleTypeDef* led_ind_clk = &htim4;
uint32_t led_ind_chn = TIM_CHANNEL_2;
TIM_HandleTypeDef* led_heartbeat_clk = &htim3;
uint32_t led_heartbeat_chn = TIM_CHANNEL_3;

bool print_readings = false;
/* USER CODE END PV */

void SystemClock_Config(void);
static void MX_GPIO_Init(void);
static void MX_CAN1_Init(void);
static void MX_FMPI2C1_Init(void);
static void MX_USART1_UART_Init(void);
static void MX_USART2_UART_Init(void);
static void MX_SPI1_Init(void);
static void MX_SPI3_Init(void);
static void MX_TIM3_Init(void);
static void MX_TIM4_Init(void);
static void MX_TIM2_Init(void);
static void MX_TIM1_Init(void);
/* USER CODE BEGIN PFP */
#ifdef __GNUC__
/* With GCC/RAISONANCE, small printf (option LD Linker->Libraries->Small printf
   set to 'Yes') calls __io_putchar() */
#define PUTCHAR_PROTOTYPE int __io_putchar(int ch)
#else
#define PUTCHAR_PROTOTYPE int fputc(int ch, FILE *f)
#endif /* __GNUC__ */
/* USER CODE END PFP */

/* USER CODE BEGIN 0 */
int print_nice_loading(uint8_t* buffer, uint16_t buff_len) {
	static uint32_t next_print_tick = 0;
	uint32_t current_tick = HAL_GetTick();

	if (current_tick < next_print_tick) {
		buffer[0] = '\0'; // Nullify the buffer
		return 0;
	}

	const uint32_t PRINT_PERIOD_TICKS = 1000;
	next_print_tick = current_tick + PRINT_PERIOD_TICKS;

	struct WingLoading load;
	wing_report_strain(&load);

	snprintf((char*) buffer, buff_len, "%.3f,%.3f,%.3f,%.3f,%.3f,%.3f,%.3f,%.3f\r\n",
			load.strain_port[2],
			load.strain_port[1],
			load.strain_port[0],
			load.strain_center,
			load.strain_starboard[0],
			load.strain_starboard[1],
			load.strain_starboard[2],
			load.torsion
			);
	return strnlen((char*) buffer, buff_len);
}
/* USER CODE END 0 */

/**
  * @brief  The application entry point.
  * @retval int
  */
int main(void)
{

  /* MCU Configuration--------------------------------------------------------*/

  /* Reset of all peripherals, Initializes the Flash interface and the Systick. */
  HAL_Init();

  /* Configure the system clock */
  SystemClock_Config();

  /* Initialize all configured peripherals */
  MX_GPIO_Init();
  MX_USB_DEVICE_Init();
  MX_CAN1_Init();
  MX_FMPI2C1_Init();
  MX_USART1_UART_Init();
  MX_USART2_UART_Init();
  MX_SPI1_Init();
  MX_SPI3_Init();
  MX_TIM3_Init();
  MX_TIM4_Init();
  MX_TIM2_Init();
  MX_TIM1_Init();
  /* USER CODE BEGIN 2 */

  struct LEDMoBoConfig led_config = {
		  .error_timer = led_err_clk,
		  .error_channel = led_err_chn,
		  .indicator_timer = led_ind_clk,
		  .indicator_channel = led_ind_chn,
		  .heartbeat_timer = led_heartbeat_clk,
		  .heartbeat_channel = led_heartbeat_chn,
  };
  led_setup(&led_config);

  wing_setup(&hcan1);
  uint8_t usb_tx_buffer[500] = {0};
  uint16_t usb_tx_length = 0;
  /* USER CODE END 2 */

  /* Infinite loop */
  /* USER CODE BEGIN WHILE */
  while (1)
  {
	  if (HAL_CAN_GetRxFifoFillLevel(&hcan1, CAN_LOAD_FIFO) > 0) {
		  CAN_RxHeaderTypeDef rx_header = {0};
		  uint8_t rx_buffer[8] = {0};
		  HAL_CAN_GetRxMessage(&hcan1, CAN_LOAD_FIFO, &rx_header, rx_buffer);

		  wing_record_strain(rx_header.StdId, rx_buffer);

	  }
    /* USER CODE END WHILE */

    /* USER CODE BEGIN 3 */
      led_operate(&led_config);

      if (print_readings) {
		  usb_tx_length = print_nice_loading(usb_tx_buffer, sizeof(usb_tx_buffer));
		  if (usb_tx_length > 0) {
			  CDC_Transmit_FS(usb_tx_buffer, usb_tx_length);
			  wing_setup(&hcan1);
		  }
      }
      HAL_Delay(10);
  }
  /* USER CODE END 3 */
}

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
/* USER CODE BEGIN 4 */
/**
  * @brief  Retargets the C library printf function to the USART.
  * @param  None
  * @retval None
  */
PUTCHAR_PROTOTYPE
{
  /* Place your implementation of fputc here */
  /* e.g. write a character to the USART1 and Loop until the end of transmission */
  HAL_UART_Transmit(&huart1, (uint8_t *)&ch, 1, 0xFFFF);

  return ch;
}

void USB_CDC_RxHandler(uint8_t* buffer, uint32_t length) {
	if (length < 1) return;
	if (length < (APP_RX_DATA_SIZE - 1)) buffer[length] = '\0'; // Null terminate

	enum CLICommandType command;
	int node_id;
	float parameter;

	int terms_found = sscanf((char*)buffer, "%c%d,%f", (char*)&command, &node_id, &parameter);

	if (terms_found == EOF) return; // Failed to acquire any command

	const size_t OUT_BUF_LEN = 1024;
	char output_message[OUT_BUF_LEN];
	output_message[0] = 0; // Default to an empty string

	int pos = 0;
	switch (command) {
	case CLI_HELP:
		print_readings = false; // Stop reading to not swamp printed message
		pos += snprintf(&output_message[pos], OUT_BUF_LEN - pos, "\n\nFALCON CALIBRATION FIRMWARE HELP\n");
		pos += snprintf(&output_message[pos], OUT_BUF_LEN - pos, "All commands follow format \"CN,P\" where:\n\tC is command character\n\tN is target node\n\tP is optional parameter\n");
		pos += snprintf(&output_message[pos], OUT_BUF_LEN - pos, "Valid command characters:\n");
		pos += snprintf(&output_message[pos], OUT_BUF_LEN - pos, "\t%c - Print this help message (no node/parameter)\n", CLI_HELP);
		pos += snprintf(&output_message[pos], OUT_BUF_LEN - pos, "\t%c - Toggle load reading printout (no node/parameter)\n", CLI_READINGS);
		pos += snprintf(&output_message[pos], OUT_BUF_LEN - pos, "\t%c - Flash a node's light P times\n", CLI_FLASH);
		pos += snprintf(&output_message[pos], OUT_BUF_LEN - pos, "\t%c - Set node strain zero point as P\n", CLI_STR_ZERO);
		pos += snprintf(&output_message[pos], OUT_BUF_LEN - pos, "\t%c - Set node strain scaling factor as P\n", CLI_STR_SCALE);
		pos += snprintf(&output_message[pos], OUT_BUF_LEN - pos, "\t%c - Set node strain gain as a power of 2 from 0 to 7\n", CLI_STR_GAIN);
		pos += snprintf(&output_message[pos], OUT_BUF_LEN - pos, "\t%c - Set node torsion zero point as P\n", CLI_TOR_ZERO);
		pos += snprintf(&output_message[pos], OUT_BUF_LEN - pos, "\t%c - Set node torsion scaling factor as P\n", CLI_TOR_SCALE);
		pos += snprintf(&output_message[pos], OUT_BUF_LEN - pos, "\t%c - Set node torsion gain as a power of 2 from 0 to 7\n", CLI_TOR_GAIN);
		pos += snprintf(&output_message[pos], OUT_BUF_LEN - pos, "\nPROCEDURE TO CALIBRATE WING LOAD MODULES:\n");
		pos += snprintf(&output_message[pos], OUT_BUF_LEN - pos, "\t0. Set gain to 0, zero point to 0, and scale to 1.0. This will provide RAV ADC readings\n");
		pos += snprintf(&output_message[pos], OUT_BUF_LEN - pos, "\t1. Increase gain until pleased with results. Max readings are +/-8388608 so avoid going too close otherwise more loading won't register!\n");
		pos += snprintf(&output_message[pos], OUT_BUF_LEN - pos, "\t2. Record/set the zero point\n");
		pos += snprintf(&output_message[pos], OUT_BUF_LEN - pos, "\t3. Determine and then set the scaling factor. If it reads 100 and 1.0 is desired, enter 0.01\n");
			break;
	case CLI_READINGS:
		print_readings = !print_readings;
		pos = snprintf(output_message, OUT_BUF_LEN, "Toggled reading printing\n");
			break;
	case CLI_FLASH:
		if (terms_found != 3) {
			pos = snprintf(output_message, OUT_BUF_LEN, "Not proper form for flash command: \"%s\". Check HELP using \"%c\".\n", buffer, CLI_HELP);
			break;
		}
		uint8_t flashes = (uint8_t)parameter;
		wing_flash_node(&hcan1, node_id, flashes, 600, 400);
		pos = snprintf(output_message, OUT_BUF_LEN, "Flashing node %d %d times\n", node_id, flashes);
			break;
	case CLI_STR_ZERO:
		if (terms_found != 3) {
			pos = snprintf(output_message, OUT_BUF_LEN, "Not proper form for strain zero command: \"%s\". Check HELP using \"%c\".\n", buffer, CLI_HELP);
			break;
		}
		int32_t str_zero_point = (int32_t)parameter;
		wing_set_strain_zero(&hcan1, node_id, str_zero_point);
		pos = snprintf(output_message, OUT_BUF_LEN, "Set node %d zero point to %ld\n", node_id, str_zero_point);
			break;
	case CLI_STR_GAIN:
		if (terms_found != 3) {
			pos = snprintf(output_message, OUT_BUF_LEN, "Not proper form for strain gain command: \"%s\". Check HELP using \"%c\".\n", buffer, CLI_HELP);
			break;
		}
		uint8_t str_gain = (uint8_t)parameter;
		if (str_gain > 7) {
			pos = snprintf(output_message, OUT_BUF_LEN, "Gain must be 0 to 7 inclusive, read %d.\n", str_gain);
			break;
		}
		wing_set_strain_gain(&hcan1, node_id, str_gain);
		pos = snprintf(output_message, OUT_BUF_LEN, "Set node %d zero point to %d\n", node_id, str_gain);
			break;
	case CLI_STR_SCALE:
		if (terms_found != 3) {
			pos = snprintf(output_message, OUT_BUF_LEN, "Not proper form for strain scale command: \"%s\". Check HELP using \"%c\".\n", buffer, CLI_HELP);
			break;
		}
		wing_set_strain_scale(&hcan1, node_id, parameter);
		pos = snprintf(output_message, OUT_BUF_LEN, "Set node %d scale factor to %f\n", node_id, parameter);
			break;



	case CLI_TOR_ZERO:
		if (terms_found != 3) {
			pos = snprintf(output_message, OUT_BUF_LEN, "Not proper form for torsion zero command: \"%s\". Check HELP using \"%c\".\n", buffer, CLI_HELP);
			break;
		}
		int32_t tor_zero_point = (int32_t)parameter;
		wing_set_torsion_zero(&hcan1, node_id, tor_zero_point);
		pos = snprintf(output_message, OUT_BUF_LEN, "Set node %d torsion zero point to %ld\n", node_id, tor_zero_point);
			break;
	case CLI_TOR_GAIN:
		if (terms_found != 3) {
			pos = snprintf(output_message, OUT_BUF_LEN, "Not proper form for torsion gain command: \"%s\". Check HELP using \"%c\".\n", buffer, CLI_HELP);
			break;
		}
		uint8_t tor_gain = (uint8_t)parameter;
		if (tor_gain > 7) {
			pos = snprintf(output_message, OUT_BUF_LEN, "Gain must be 0 to 7 inclusive, read %d.\n", tor_gain);
			break;
		}
		wing_set_torsion_gain(&hcan1, node_id, tor_gain);
		pos = snprintf(output_message, OUT_BUF_LEN, "Set node %d torsion gain to %d\n", node_id, tor_gain);
			break;
	case CLI_TOR_SCALE:
		if (terms_found != 3) {
			pos = snprintf(output_message, OUT_BUF_LEN, "Not proper form for torsion scale command: \"%s\". Check HELP using \"%c\".\n", buffer, CLI_HELP);
			break;
		}
		wing_set_torsion_scale(&hcan1, node_id, parameter);
		pos = snprintf(output_message, OUT_BUF_LEN, "Set node %d scale factor to %f\n", node_id, parameter);
			break;



	case CLI_UNKNOWN:
	default:
		pos = snprintf(output_message, OUT_BUF_LEN, "Command not recognized \"%s\"\n", buffer);
		break;
	}

	if (output_message[0] == 0) return;

	CDC_Transmit_FS((uint8_t*)output_message, pos);
	//printf("%s", output_message);
}
/* USER CODE END 4 */
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
