hpvdt/falcon_motherboard/(commit log)

2024-02-02 note to look @ schematic
2024-02-10 Baseline USB functionality verified
    Issues found in hardware, USB D+ and D- signal are going to the wrong pins on the MCU of the rev. 1 board.
    [main.cpp]
2024-02-23 Fixed pin allocations for IMU
    [main.cpp]
2024-02-23 code to partially incorporate some LEDs
2024-02-23 code to partially incorporate LEDs
2024-03-01 importing previously written sensor code from other repos
2024-03-08 LIDAR test code work
2024-03-08 LIDAR I2C stuff to do in the future
2024-03-09 fixed printf statement
2024-03-09 start of IMU wrapper functions
2024-03-22 sending iterating values to prop control board
2024-03-23 IMU wrapper functions done
2024-03-27 merged IMU, DHT, CO2 sensor libraries
2024-03-27 added print functions for IMU, DHT, and CO2 libraries
2024-04-05 lidar wrapper functions fixed and code compiles
    [main.cpp]
2024-04-10 removing DHT & IMU reliance on global variables
2024-04-10 Working Lidar
2024-04-10 I2C bus declared in main
2024-04-12 Modified BNO libraries to allow setting I2C adress outside of constructor - ready to test
2024-04-13 Working code for all three sensors
2024-04-13 Gave IMU and DHT functions their required arguments
2024-07-10 Starting radio code
    Code is being reworked to keep most of radio work out of `main.cpp`.
    Reworked so references are used instead of pass-by-copy to make code
    easier to reuse safely.
    Also added constants for radios based on rev 3 schematic.
    [main.cpp]
2024-12-04 Removed conditional Arduino code from OneWire
2024-12-06 Fixed CO2 print
2024-12-06 Changed one wire testing to scan a range of nodes
2024-12-15 Updated checksum for one wire protocol
2025-01-11 LOAD TEST CODE
    Set up for the load test which was unattended by Savo.
    Performs a few self-tests of the strain gauges then prints their readings in human readable and CSV parsable text.
    Hope it works as intended!
2025-01-11 Fixed communication for pretty strain message
    [communications.cpp]
2025-08-17 Reorganization of the folder and upload of the hardware designs
    [motherboard_rev_0.kicad_sch, motherboard_rev_1.kicad_pcb, motherboard_rev_1.kicad_sch, motherboard_rev_2.kicad_pcb, motherboard_rev_2.kicad_sch, motherboard_rev_3.kicad_pcb, motherboard_rev_3.kicad_sch]
2025-08-20 Settled on pin out
    [can.kicad_sch, motherboard_rev_3.kicad_pcb, motherboard_rev_3.kicad_sch, power.kicad_sch]
2025-08-20 Started STM32CubeIDE project
2025-08-20 Completed schematic for rev 3.0 PCB
    [can.kicad_sch, motherboard_rev_3.kicad_pcb, motherboard_rev_3.kicad_sch, power.kicad_sch]
2025-08-20 Avoid KiCad recovery files
2025-08-23 Fixed up a symbol power pins
2025-08-23 Removed LDO and just regulate to 3.3V, also removed off board CO2
    [can.kicad_sch, motherboard_rev_3.kicad_sch, power.kicad_sch]
2025-08-23 Completed layout except for radio modules
    [motherboard_rev_3.kicad_pcb, motherboard_rev_3.kicad_sch]
2025-08-23 Added schematic for future integrated nRF24 modules
    [motherboard_rev_3.kicad_sch, nrf24.kicad_sch]
2025-08-23 Motherboard rev 3.1 as ordered
    [motherboard_rev_3.kicad_pcb, motherboard_rev_3.kicad_sch, power.kicad_sch]
2025-09-07 Testing out USB on the main motherboard firmware
    Doesn't seem to work for some reason, perhaps a slight clash with other peripherals like TIM1 or USART1
    [main.c, mother_board.ioc]
2025-09-13 Added LED code
2025-09-14 Added hardware UART `printf()`
2025-09-16 Achieved communication with wing modules
2025-10-26 Recorded correct node addresses for wing loads
    [wing_modules.c, wing_modules.h]
2025-10-26 Started on calibration firmware
2025-10-26 Renamed project for general Falcon calibration
2025-10-26 Implemented calibration functions for load sensing
2025-10-26 Added calibration procedure to help command
2025-11-09 Completed driver for INA219 power sensor
2025-11-09 Added library for SCD41 CO2 sensor
2025-11-11 Prepared `README.md` for calibration firmware
2025-11-13 Added section for wing load readings
2025-11-16 Ported communications code and adapted it for STM32Cube project
